marknguy/GarageDoorESP8266/README.md

# GarageDoorESP8266
This allows you to control two garage doors using an ESP8266-01
