marknguy/GarageDoorESP8266/(threads)

Thread 1 (2019-02-03):

Connection reset error when clicking the 'open door' button

jay-99, 2019-02-03:
When clicking on the 'open door' button, the browser returns a 'connection was reset' page (note that this problem doesn't occur on IE11 but does on all other browsers I've tried).  Quite a few forums suggest that a content-length needs to be added to the HTML header, however I haven't been able to get this working most likely because I'm not implementing correctly.

The line that I think needs adjusting is the countdown timer HTML header which looks like this:
String response = "HTTP/1.1 200 OK\r\nContent-Type: text/html\r\n\r\n";

I have tried many variations adding the content-length such as this:
String response = "HTTP/1.1 200 OK\r\nContent-Type: text/html\r\nContent-Length: 87\r\n\r\n";
but I still can't get it working.  The above code actually goes to a blank webpage (no connection reset error) which suggests to me that I am looking in the right area.  I have tried many other lengths and also tied to implement code that counts the length but I can't get any of it to work.  Is it simply because I have the wrong content-length (I'm not 100% sure how I should be determining this) or something else?

--  Sorry if this is not how you normally post an issue or if my etiquette is not correct - it's my first time using GitHub :)
